k2nxf/hareproject/documents/working_test_no_chip.png

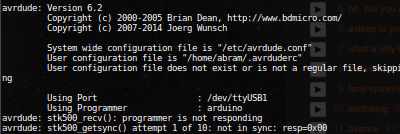
documents/working_test_no_chip.png
