k2nxf/hareproject/README.md

# hareproject
The hackable audio and real-time effects (H.A.R.E) project
