k2nxf/hareproject/documents/Homework 5 - Team 13.pdf

Homework #5
System Design: Functional Decomposition HARE Project

Team 13
Adam Oester
Abram Morphew
Zachary Clark-Williams
Ryan Fallis
High-Level | Block | Diagram:

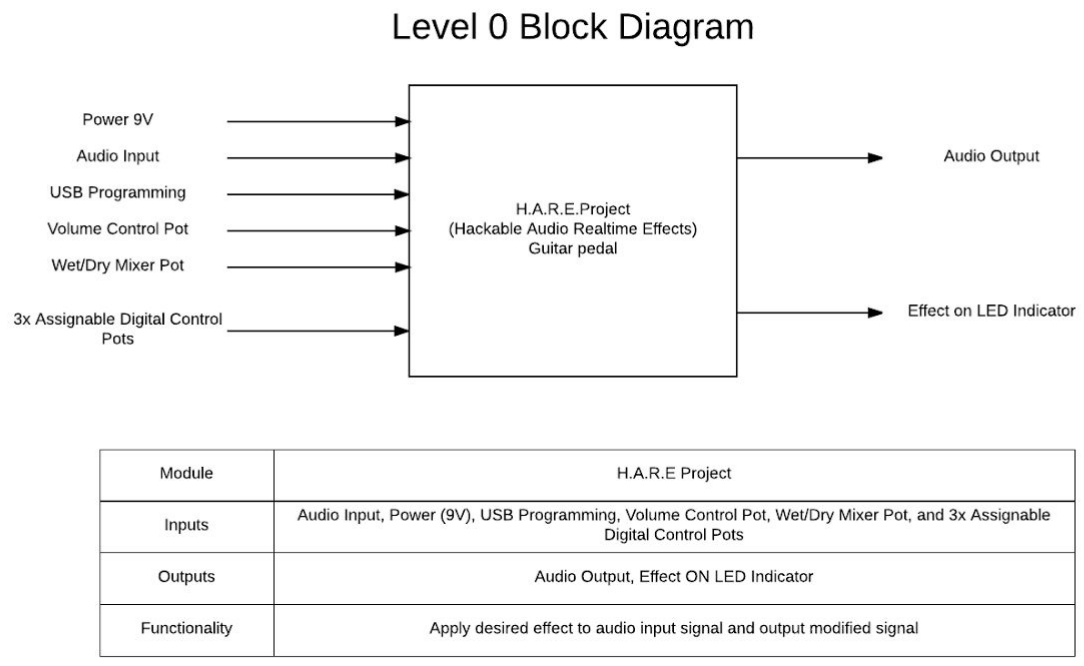
[picture p2: figure]

Next-Level | Block | Diagram:
| | Level 1 Block Diagram

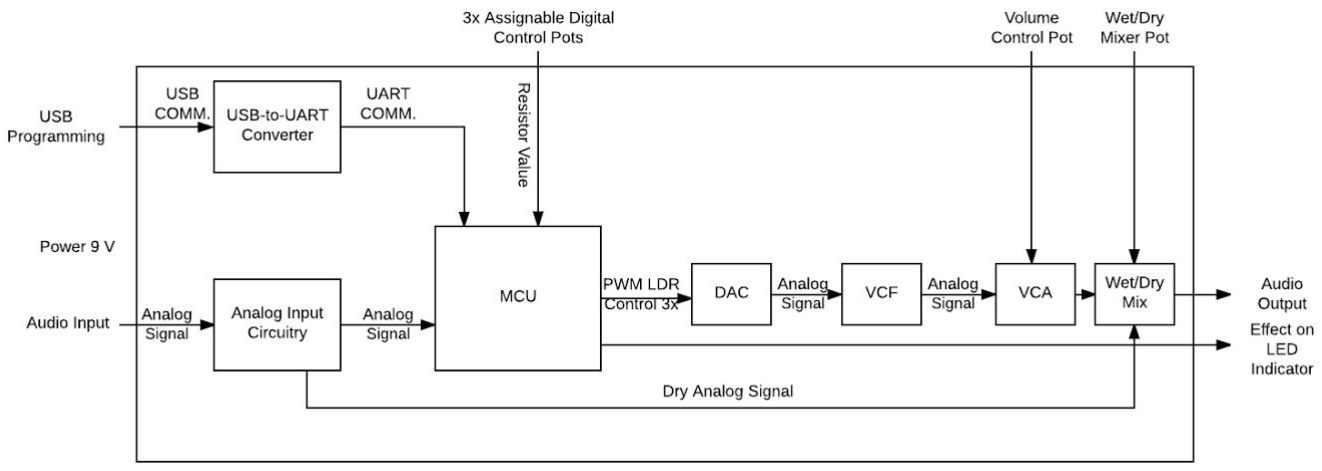
[picture p3: figure]

Top-Level | Module | Diagrams:
| | Top-Level Analog Input Circuitry

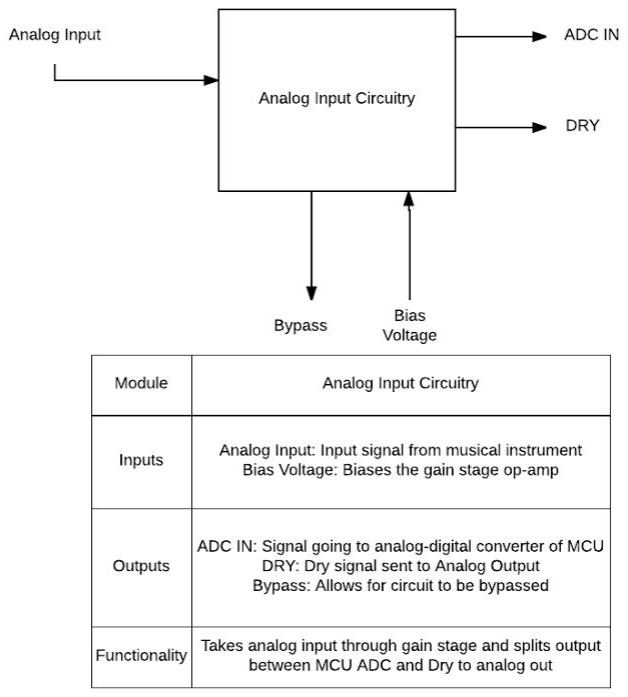
[picture p4: figure]

Top-Level USB-to-UART Diagram

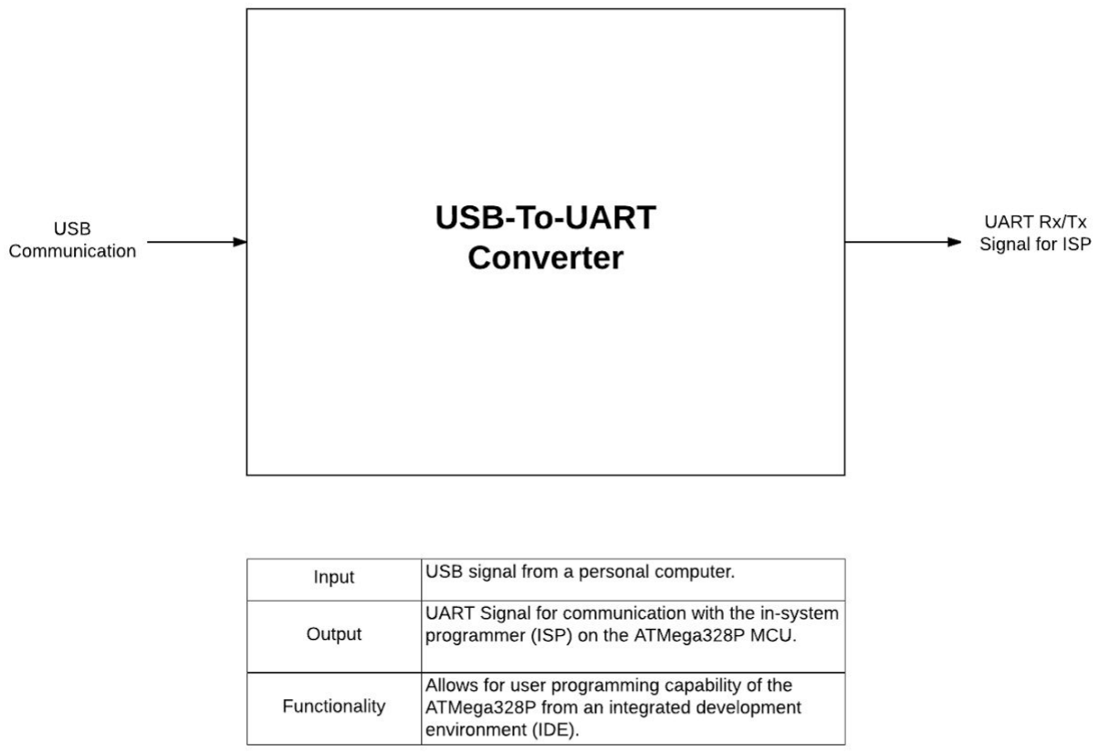
[picture p5: figure]

Top-Level MCU Diagram

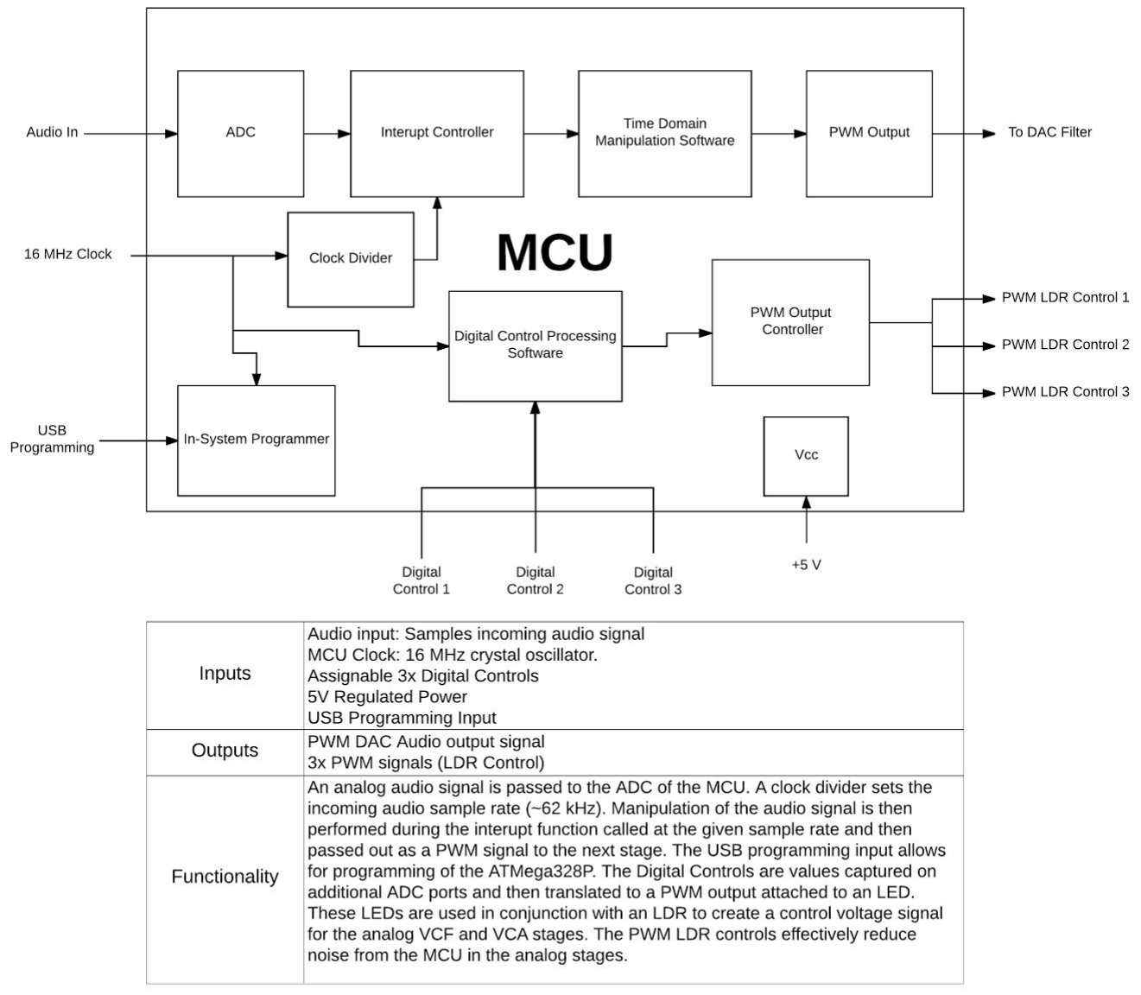
[picture p6: figure]

Top-Level PWM DAC Filter Diagram

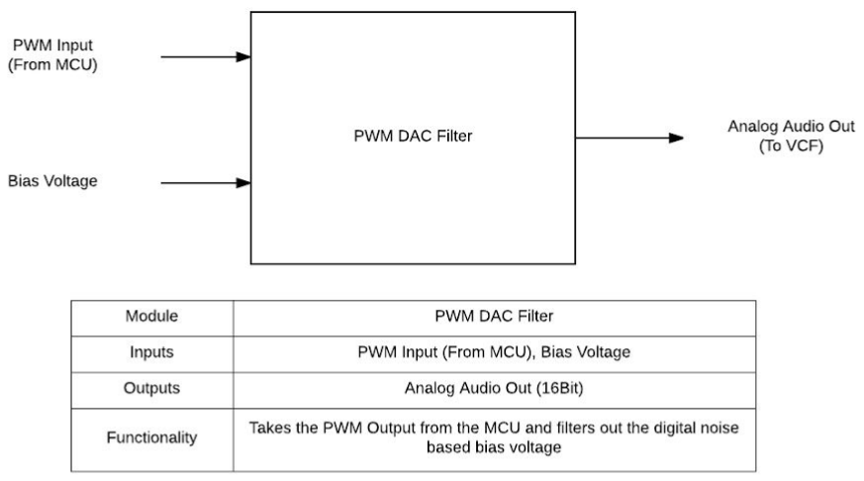
[picture p7: figure]

Top-Level Voltage Controlled Filter Diagram

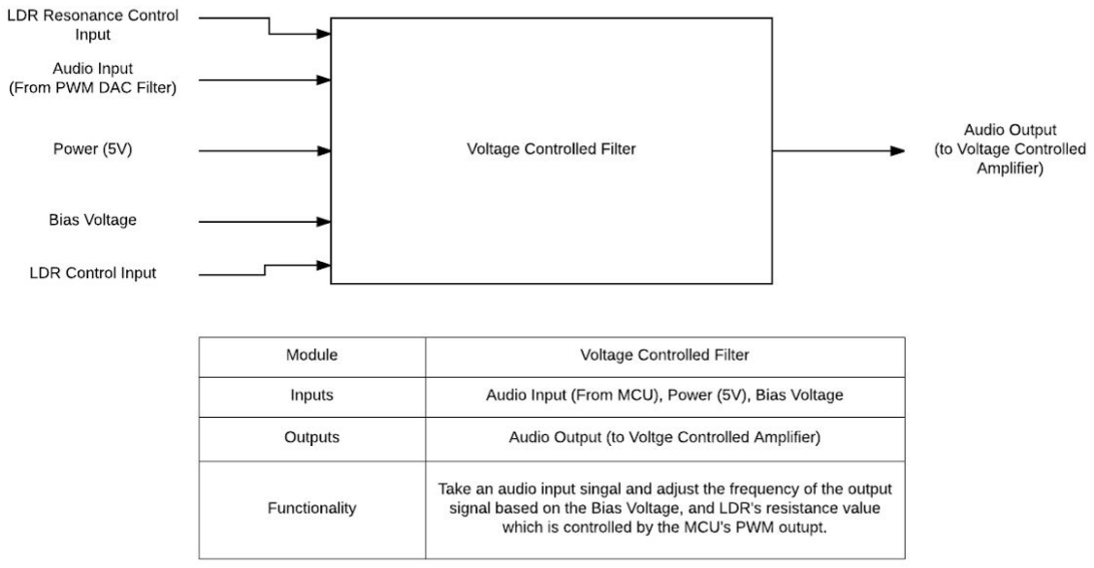
[picture p8: figure]

Top-Level Voltage-Controlled Amplifier Diagram

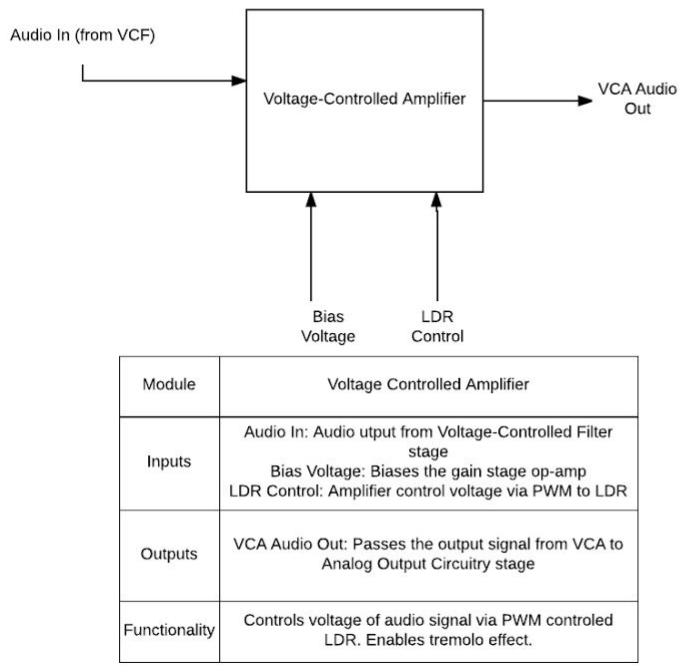
[picture p9: figure]

Top-Level Analog Output Circuitry Diagram

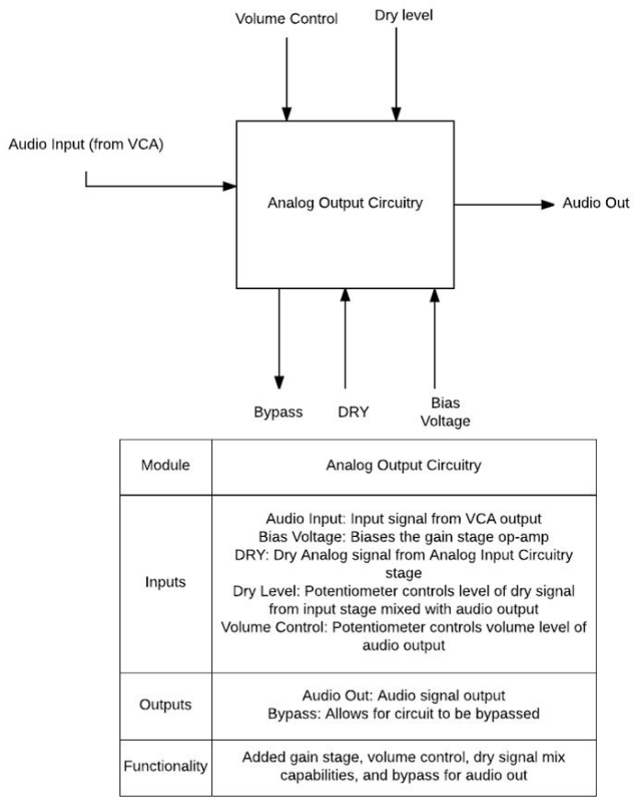
[picture p10: figure]
