k2nxf/hareproject/measurements/MCP4921_spectrum_1kHz.csv

Frequency (Hz) | Level (dB) | Frequency (kHz)
43.066406 | -49.579975 | 0.043066406
86.132812 | -50.937241 | 0.086132812
129.199219 | -65.967857 | 0.129199219
172.265625 | -69.474319 | 0.172265625
215.332031 | -72.966713 | 0.215332031
258.398438 | -74.523582 | 0.258398438
301.464844 | -70.056686 | 0.301464844
344.53125 | -74.955704 | 0.34453125
387.597656 | -77.206894 | 0.387597656
430.664062 | -75.691528 | 0.430664062
473.730469 | -78.37793 | 0.473730469
516.796875 | -73.04731 | 0.516796875
559.863281 | -72.713318 | 0.559863281
602.929688 | -78.147095 | 0.602929688
645.996094 | -76.161964 | 0.645996094
689.0625 | -77.673492 | 0.6890625
732.128906 | -81.486855 | 0.732128906
775.195312 | -80.535179 | 0.775195312
818.261719 | -76.385254 | 0.818261719
861.328125 | -68.273315 | 0.861328125
904.394531 | -48.475349 | 0.904394531
947.460938 | -24.801308 | 0.947460938
990.527344 | -16.720667 | 0.990527344
1033.59375 | -21.779499 | 1.03359375
1076.660156 | -42.519596 | 1.076660156
1119.726562 | -58.266113 | 1.119726562
1162.792969 | -62.753113 | 1.162792969
1205.859375 | -65.15596 | 1.205859375
1248.925781 | -66.968468 | 1.248925781
1291.992188 | -68.733795 | 1.291992188
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
