k2nxf/hareproject/documents/3pdt_breakout.png

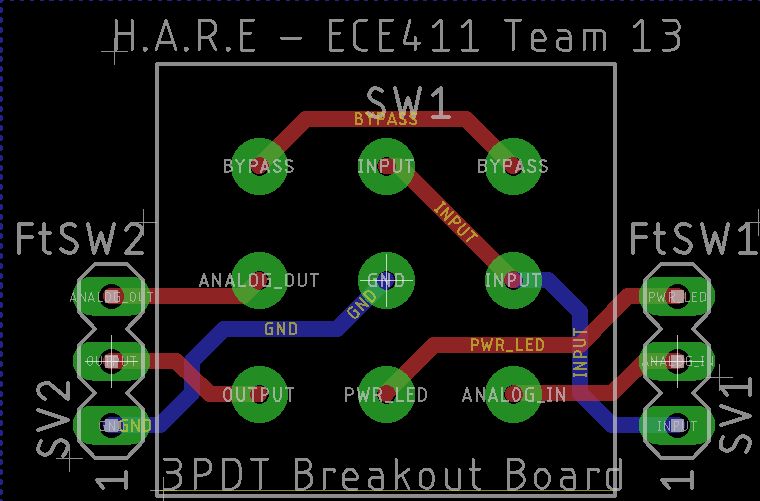
documents/3pdt_breakout.png
