k2nxf/hareproject/documents/arduino_due_fuse.png

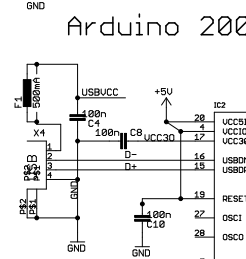
documents/arduino_due_fuse.png
