k2nxf/hareproject/documents/atmega328p.png

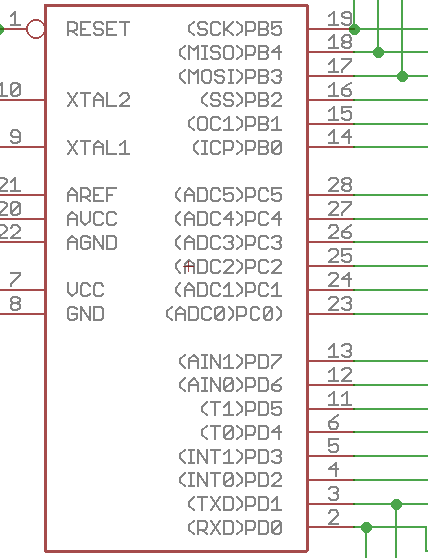
documents/atmega328p.png
