k2nxf/hareproject/documents/HARE_RAW.png

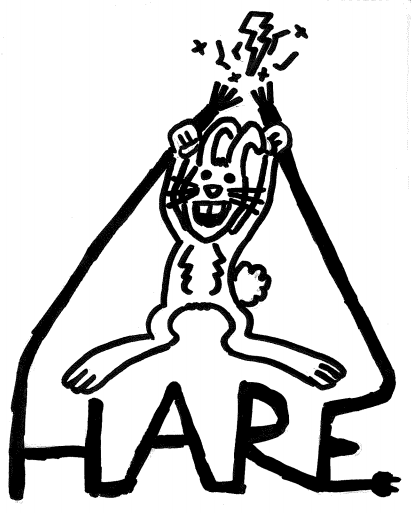
documents/HARE_RAW.png
