k2nxf/hareproject/documents/reset_conn.png

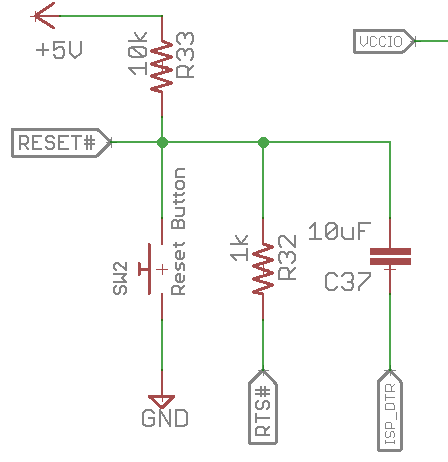
documents/reset_conn.png
