k2nxf/hareproject/schematics/SUPERBUN.bmp

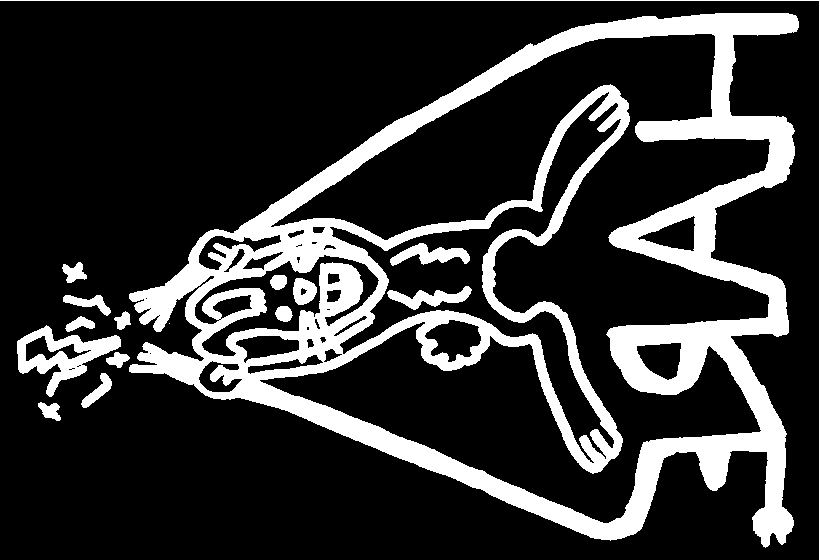
schematics/SUPERBUN.bmp
