k2nxf/hareproject/documents/Mouser_Cart_Oct23_1145PM.xls

SHOPPING CART
This is not an invoice
24-Oct-17 19:49:08
 | Mouser # | Mfr. # | Manufacturer | Customer # | Description | RoHS | Lifecycle | Order Qty. | Price (USD) | Ext.: (USD)
1 | 550-22302 | NMJ6HCD2 | Neutrik |  | Phone Connectors STEREO CHROME NOSE | RoHS Compliant |  | 14 | $1.32 | $18.48
2 | 667-ERJ-6RBD1003V | ERJ-6RBD1003V | Panasonic |  | Thick Film Resistors - SMD 0805 Resistor 0.5% 50ppm 100KOhm | RoHS Compliant | New Product | 100 | $0.045 | $4.50
3 | 754-RR1220P-103D | RR1220P-103-D | Susumu |  | Thin Film Resistors - SMD 1/10W 10Kohm 0.5% 25ppm | RoHS Compliant |  | 100 | $0.03 | $3.00
4 | 754-RR1220P-102D | RR1220P-102-D | Susumu |  | Thin Film Resistors - SMD 1/10W 1Kohm 0.5% 25ppm | RoHS Compliant |  | 100 | $0.03 | $3.00
5 | 754-RG2012P-473DT5 | RG2012P-473-D-T5 | Susumu |  | Thin Film Resistors - SMD 1/8W 47K Ohms 0.5% 0805 25ppm | RoHS Compliant |  | 30 | $0.16 | $4.80
6 | 81-GRM40X104K25L | GRM21BR71E104KA01L | Murata |  | Multilayer Ceramic Capacitors MLCC - SMD/SMT 0805 0.1uF 25volts X7R 10% | RoHS Compliant |  | 30 | $0.024 | $0.72
7 | 81-GCM21BR71E105KA6L | GCM21BR71E105KA56L | Murata |  | Multilayer Ceramic Capacitors MLCC - SMD/SMT 0805 1uF 25volts X7R 10% | RoHS Compliant |  | 100 | $0.062 | $6.20
8 | 963-TMK212BBJ106KGHT | TMK212BBJ106KGHT | Taiyo Yuden |  | Multilayer Ceramic Capacitors MLCC - SMD/SMT 10uF 25V X5R +/-10% 0805 AEC-Q200 | RoHS Compliant |  | 30 | $0.243 | $7.29
9 | 963-TMK212BJ224KGHT | TMK212BJ224KGHT | Taiyo Yuden |  | Multilayer Ceramic Capacitors MLCC - SMD/SMT 0.22uF 25V X5R +/-10% 0805 AEC-Q200 | RoHS Compliant |  | 30 | $0.055 | $1.65
10 | 538-67068-7041 | 67068-7041 | Molex |  | USB Connectors 4CKT TYPE B RECPT | RoHS Compliant |  | 5 | $1.33 | $6.65
11 | 895-FT232RL | FT232RL-REEL | FTDI |  | USB Interface IC USB to Serial UART Enhanced IC SSOP-28 | RoHS Compliant |  | 5 | $4.50 | $22.50
12 | 490-PJ-102B | PJ-102B | CUI Inc. |  | DC Power Connectors Power Jacks | RoHS Compliant |  | 5 | $0.64 | $3.20
13 | 863-MC7805BDTRKG | MC7805BDTRKG | ON Semiconductor |  | Linear Voltage Regulators 5V 1A Positive | RoHS Compliant |  | 10 | $0.52 | $5.20
14 | 72-TS53YL-10K | TS53YL103MR10 | Vishay |  | Trimmer Resistors - SMD 10Kohms 20% SQ POT | RoHS Compliant By Exemption |  | 10 | $1.25 | $12.50
15 | 710-742792093 | 742792093 | Wurth Electronics |  | Ferrite Beads WE-CBF 0805 SMD Bead 100MHz 2200Ohm 200mA | RoHS Compliant |  | 10 | $0.20 | $2.00
16 | 603-RC0805JR-072K2L | RC0805JR-072K2L | Yageo |  | Thick Film Resistors - SMD 2.2K OHM 5% | RoHS Compliant |  | 20 | $0.013 | $0.26
By submitting your order you agree to these terms and conditions. (https://www.mouser.com/saleterms) |  |  |  |  |  |  |  |  | Merchandise Total: | $101.95
Prices are reflected at the date and time shown. |  |  |  |  |  |  |  |  | Shipping Charge: | Estimate
