k2nxf/hareproject/documents/INPUT_TEST.xlsx

Test Writer: Adam Oester
Test Case Name: |  | Input signal pass through |  |  | Test ID #: | INPUT_TEST
Description: |  | The user sends in a known input signal (100 Hz, 1 kHz and 10 kHz) to the input op-amp set to a known gain (Unity, 3, 6, and 9). The user then records both the input and the output signal for analysis. |  |  | Type: | black box
Tester Information
Name of Tester: |  | Adam Oester |  | Date: |  | 2017-12-05
Hardware Version: |  | HAREproject Rev 1.0 |  | Time: |  | 23:37:00
Setup: |  | HARE guitar pedal main board with at least the input circuitry populated. Function generator and oscilloscope channel 1 hooked-up to the op-amp input and oscilloscope channel 2 hooked-up to the input circuitry output.
Special instructions: |  | Hook input and output up to oscilloscope, use function generator to create known analog input signal, ensure to record gain setting and capture oscilloscope screen capture
Step | Action | Expected Result | Pass | Fail | N/A | Comments
1 | 100 Hz input signal at unity gain | Clean output signal @ 100 Hz +/- 50 Hz with no distortion or harmonics. Ensure signal has unity gain. | PASS |  |  | This test is being completed on a fully populated board. No major harmonic signals present.
2 | 1 kHz input signal at unity gain | Clean output signal @ 1 kHz +/- 50 Hz with no distortion or harmonics. Ensure signal has unity gain. | PASS
3 | 10 kHz input signal at unity gain | Clean output signal @ 10 kHz +/- 50 Hz with no distortion or harmonics. Ensure signal has unity gain. | PASS
4 | 100 Hz input signal at gain of 3 | Clean output signal @ 100 Hz +/- 50 Hz with no distortion or harmonics. Ensure signal has gain of 3. | PASS
5 | 1 kHz input signal at gain of 3 | Clean output signal @ 1 kHz +/- 50 Hz with no distortion or harmonics. Ensure signal has gain of 3. | PASS
6 | 10 kHz input signal at gain of 3 | Clean output signal @ 10 kHz +/- 50 Hz with no distortion or harmonics. Ensure signal has gain of 3. | PASS
7 | 100 Hz input signal at gain of 6 | Clean output signal @ 100 Hz +/- 50 Hz with no distortion or harmonics. Ensure signal has gain of 6. | PASS |  | Marginal Pass. See Comments | Unit has gain of slightly less than 6. Gain is ~5.5
8 | 1 kHz input signal at gain of 6 | Clean output signal @ 1 kHz +/- 50 Hz with no distortion or harmonics. Ensure signal has gain of 6. | PASS |  | Marginal Pass. See Comments | Unit has gain of slightly less than 6. Gain is ~5.5
9 | 10 kHz input signal at gain of | Clean output signal @ 10 kHz +/- 50 Hz with no distortion or harmonics. Ensure signal has gain of 6. | PASS |  | Marginal Pass. See Comments | Unit has gain of slightly less than 6. Gain is ~5.5
Overall Test Result: |  |  | PASS |  |  | Units gain tops out at approximately 5.5.
