k2nxf/hareproject/measurements/ADC-to-DAC_pass-through_at_1kHz_20171116.png

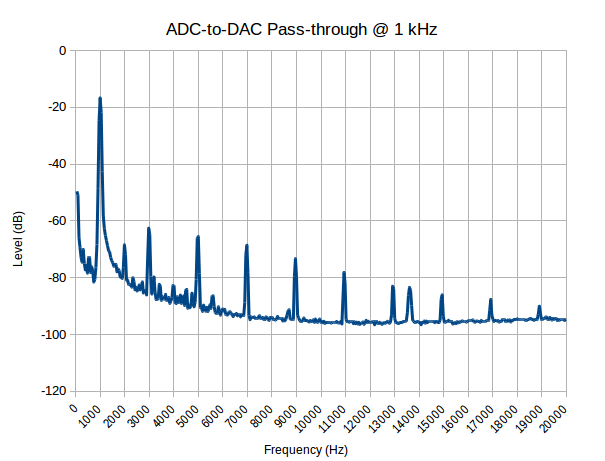
measurements/ADC-to-DAC_pass-through_at_1kHz_20171116.png
