k2nxf/hareproject/measurements/HARE_Analog_input_20171105a.png

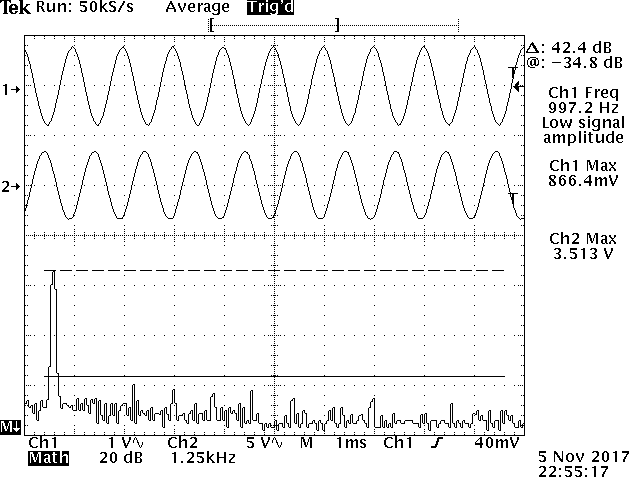
measurements/HARE_Analog_input_20171105a.png
