k2nxf/hareproject/measurements/HARE_Analog_out_20171105a.png

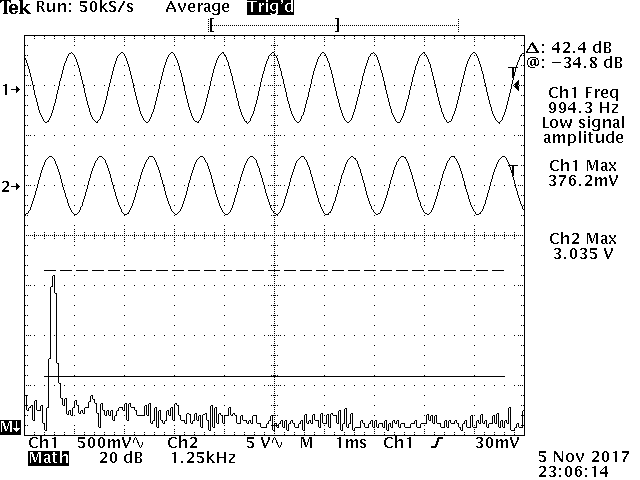
measurements/HARE_Analog_out_20171105a.png
