k2nxf/hareproject/measurements/HARE_PWMDAC_20171105c.png

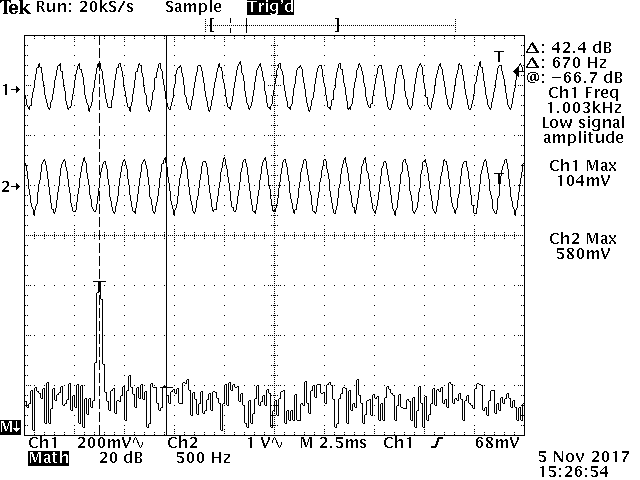
measurements/HARE_PWMDAC_20171105c.png
