k2nxf/hareproject/measurements/HARE_SPI_SCK_MOSI_20171115.png

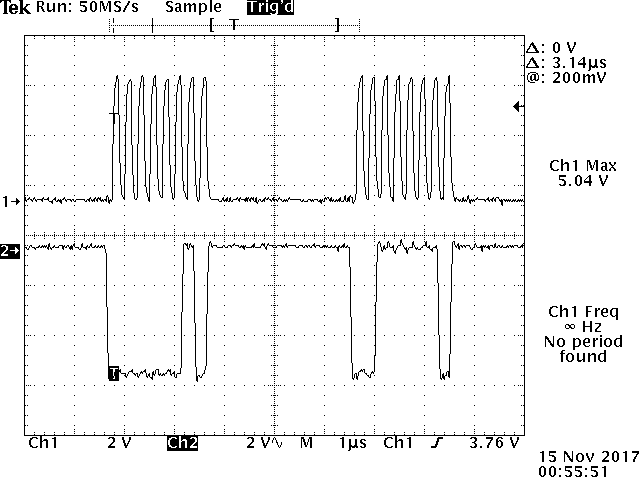
measurements/HARE_SPI_SCK_MOSI_20171115.png
