k2nxf/hareproject/documents/Project_schedule_full.pdf

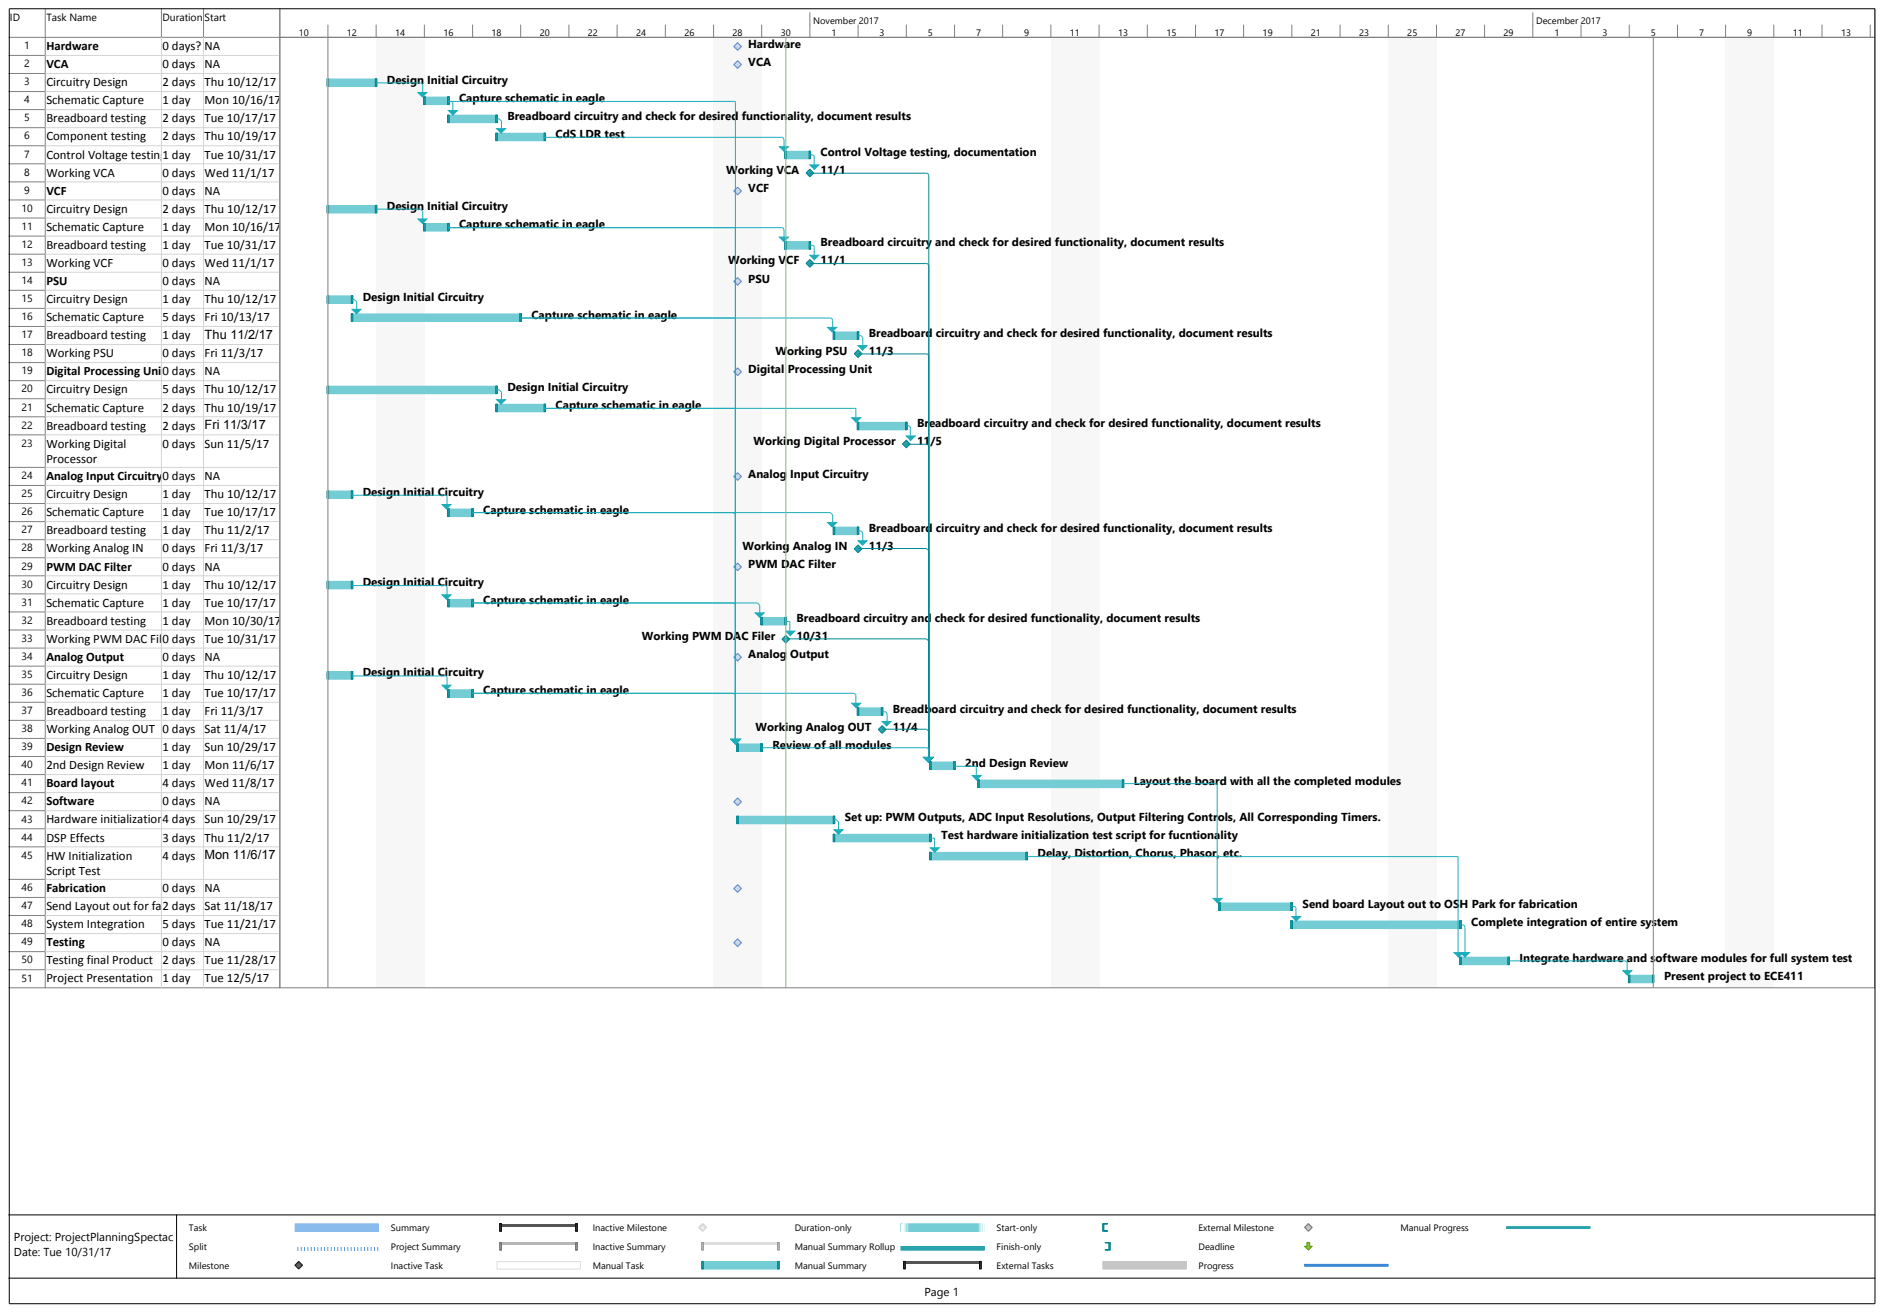
[picture p25: page 1]
Task Name; Duration Start; Hardware; 0 days? NA; VCA; Working VCA; VCF; Working VCF; PSU; Working PSU; Working Digital Processor; Working Analog IN; Working PWM DAC Filer; Analog Output; Working Analog OUT; 2nd Design Review; November 2017; December 2017; Task; Split; Milestone; Summary; Project Summary; Inactive Task; Inactive Milestone; Inactive Summary; Manual Task; Duration-only; Manual Summary; Start-only; Finish-only; External Tasks; External Milestone; Deadline; Progress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

2 | VCA | 0 days | NA
3 | Circuitry Design | 2 days | Thu 10/12/17
4 | Schematic Capture | 1 day | Mon 10/16/17
5 | Breadboard testing | 2 days | Tue 10/17/17
6 | Component testing | 2 days | Thu 10/19/17
7 | Control Voltage testing1 day | | Tue 10/31/17
8 | Working VCA | 0 days | Wed 11/1/17
9 | VCF | 0 days | NA
10 | Circuitry Design | 2 days | Thu 10/12/17
11 | Schematic Capture | 1 day | Mon 10/16/17
12 | Breadboard testing | 1 day | Tue 10/31/17
13 | Working VCF | 0 days | Wed 11/1/17
14 | PSU | 0 days | NA
15 | Circuitry Design | 1 day | Thu 10/12/17
16 | Schematic Capture | 5 days | Fri 10/13/17
17 | Breadboard testing | 1 day | Thu 11/2/17
18 | Working PSU | 0 days | Fri 11/3/17
19 | Digital Processing Unit0 days | | NA
20 | Circuitry Design | 5 days | Thu 10/12/17
21 | Schematic Capture | 2 days | Thu 10/19/17
22 | Breadboard testing | 2 days | Fri 11/3/17
23 | Working Digital Processor | 0 days | Sun 11/5/17

Design Initial Circuitry

Capture schematic in eagle

Breadboard circuitry and check for desired functionality, document results

CdS LDR test

Control Voltage testing, documentation

Digital Processing Unit

24 | Analog Input Circuitry0 days | | NA
25 | Circuitry Design | 1 day | Thu 10/12/17
26 | Schematic Capture | 1 day | Tue 10/17/17
27 | Breadboard testing | 1 day | Thu 11/2/17
28 | Working Analog IN | 0 days | Fri 11/3/17
29 | PWM DAC Filter | 0 days | NA
30 | Circuitry Design | 1 day | Thu 10/12/17
31 | Schematic Capture | 1 day | Tue 10/17/17
32 | Breadboard testing | 1 day | Mon 10/30/17
33 | Working PWM DAC Filer0 days | | Tue 10/31/17
34 | Analog Output | 0 days | NA
35 | Circuitry Design | 1 day | Thu 10/12/17
36 | Schematic Capture | 1 day | Tue 10/17/17
37 | Breadboard testing | 1 day | Fri 11/3/17
38 | Working Analog OUT | 0 days | Sat 11/4/17
39 | Design Review | 1 day | Sun 10/29/17
40 | 2nd Design Review | 1 day | Mon 11/6/17
41 | Board layout | 4 days | Wed 11/8/17
42 | Software | 0 days | NA
43 | Hardware initialization4 days | | Sun 10/29/17
44 | DSP Effects | 3 days | Thu 11/2/17
45 | HW Initialization Script Test | 4 days | Mon 11/6/17

Analog Input Circuitry

PWM DAC Filter

Review of all modules

Layout the board with all the completed modules

Set up: PWM Outputs, ADC Input Resolutions, Output Filtering Controls, All Corresponding Timers.

Test hardware initialization test script for fucntionality

Delay, Distortion, Chorus, Phasor, etc.

46 | Fabrication | 0 days | NA
47 | Send Layout out for fabrication 2 days | | Sat 11/18/17
48 | System Integration | 5 days | Tue 11/21/17
49 | Testing | 0 days | NA
50 | Testing final Product | 2 days | Tue 11/28/17
51 | Project Presentation | 1 day | Tue 12/5/17

Send board Layout out to OSH Park for fabrication

Complete integration of entire system

Integrate hardware and software modules for full system test

Present project to ECE411

Manual Summary Rollup
