k2nxf/hareproject/documents/Drawing+NMJ6HCD2.pdf

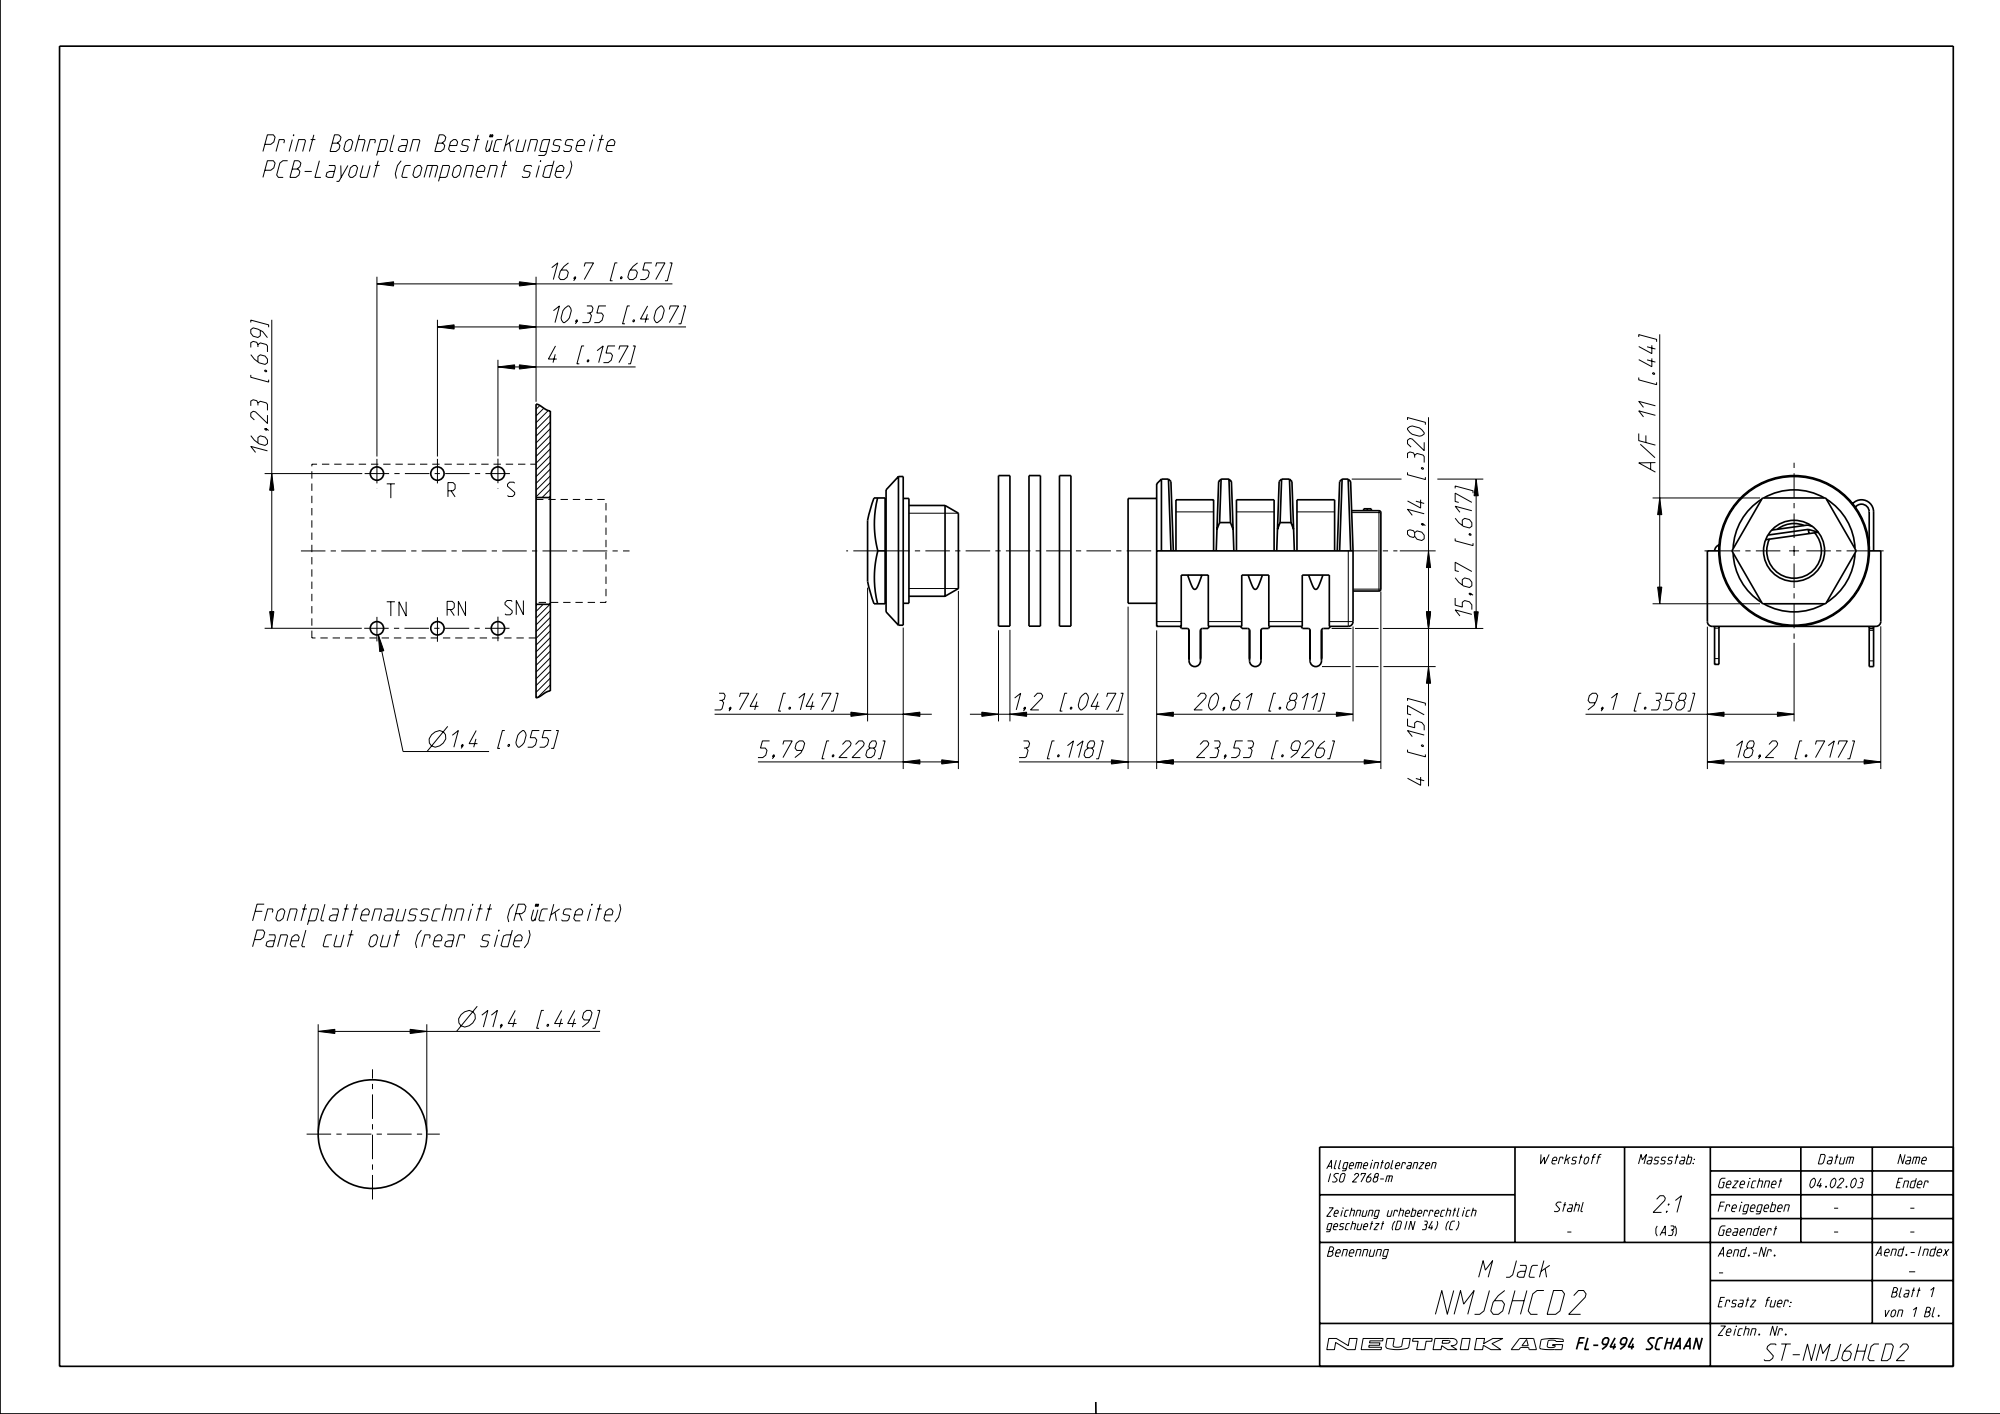
[picture p26: page 1]
