k2nxf/hareproject/simulations/simple_VCF_simulation.asc

C1: cap; 100µ
C2: cap; 10µ
C3: cap; 0.47µ
C4: cap; 0.22µ
C5: cap; 0.22µ
C6: cap; 1µ
C7: cap; 100p
D1: diode; 1N4148
R1: res; 10k
R2: res; 10k
R3: res; 47k
R4: res; 100k
R5: res; 400
R6: res; 100k
R7: res; 1k
R8: res; 1k
R9: res; 50k
R10: res; 50k
U1: BA4580R
V1: voltage; 9.6V
V2: voltage; SINE(0 0.1 1k); AC 1
V3: voltage; {Vc}; Rser=4
Named nets: 0, Vcc, Vb, Vout, CV
.ac oct 1000 1 100MEG
.step param Vc 0 5 1
