k2nxf/hareproject/schematics/HARE - Master Schematic v2.0.brd

## EAGLE design schematics/HARE - Master Schematic v2.0.brd (2017-12-10)

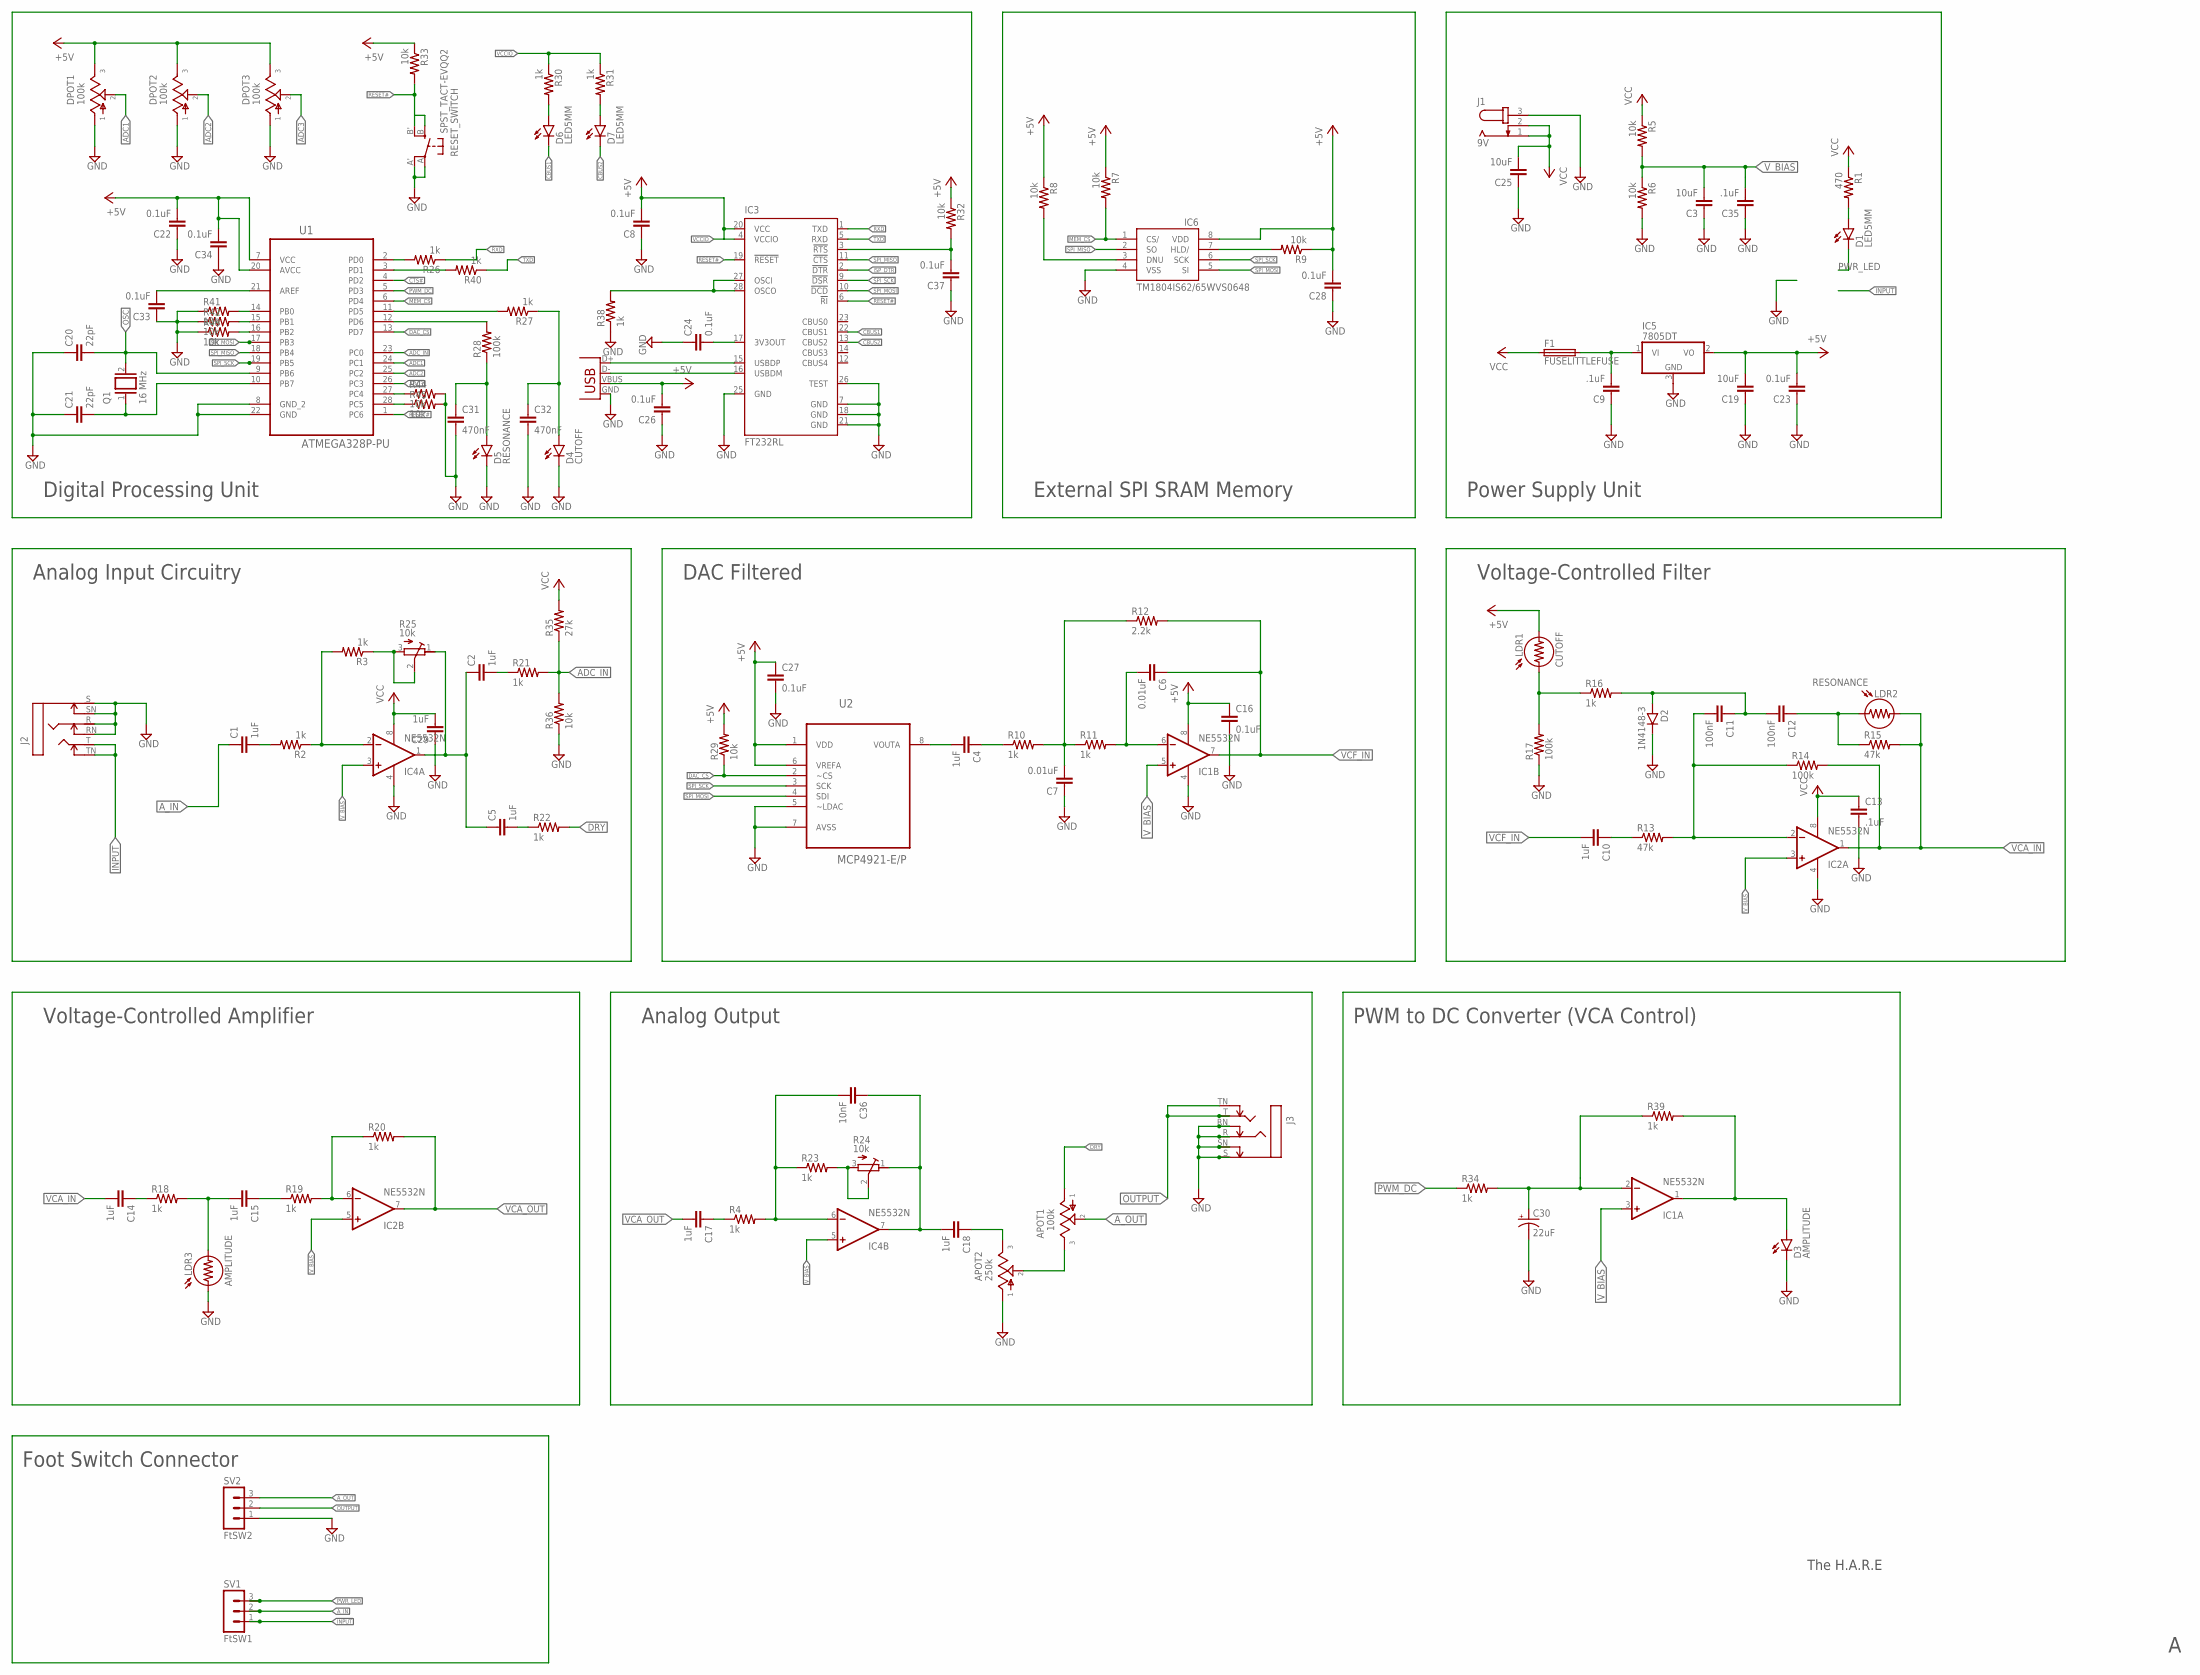
[picture p27: schematic HARE - Master Schematic v2.0.sch]

Parts:
APOT1: 100k; 16MM-SQUARE
APOT2: 250k; 16MM-SQUARE
C1, C2, C4, C5, C10, C14, C15, C17, C18, C29: 1uF; C0805K
C3, C19, C25: 10uF; C0805K
C6, C7: 0.01uF; C0805K
C8, C16, C22, C23, C24, C26, C27, C28, C33, C34, C37: 0.1uF; C0805K
C9, C13, C35: .1uF; C0805K
C11, C12: 100nF; C0805K
C20, C21: 22pF; C0805K
C30: 22uF; 050_020_1
C31, C32: 470nF; 072X035
C36: 10nF; C0805K
D1, D6, D7: LED5MM
D2: 1N4148-3; DO35-3
D3: AMPLITUDE; LED5MM
D4: CUTOFF; LED5MM
D5: RESONANCE; LED5MM
DPOT1, DPOT2, DPOT3: 100k; 16MM-SQUARE
F1: FUSELITTLEFUSE; LITTLEFUSE
IC1, IC2, IC4: NE5532N; DIL08
IC3: FT232RL; SSOP28
IC5: 7805DT; TO252
IC6: TM1804IS62/65WVS0648; SO08
J1: 9V; SPC4078
J2, J3: STEREOSW; NMJ6HCD2
LDR1: CUTOFF; LDR338-54C
LDR2: RESONANCE; LDR338-54C
LDR3: AMPLITUDE; LDR338-54C
Q1: 16 MHz; QS
R1: 470; M0805
R2, R3, R4, R10, R11, R16, R18, R19, R20, R21, R22, R23, R26, R27, R30, R31, R34, R38, R39, R40: 1k; R0805
R5, R6, R7, R8, R9: 10k; M0805
R12: 2.2k; R0805
R13, R15: 47k; R0805
R14, R17, R28: 100k; R0805
R24, R25: 10k; RTRIM3314G
R29, R32, R33, R36, R41, R42, R43, R44, R45: 10k; R0805
R35: 27k; R0805
RESET_SWITCH: SPST_TACT-EVQQ2; EVQ-Q2
SV1: FtSW1; MA03-1
SV2: FtSW2; MA03-1
U1: ATMEGA328P-PU; DIP254P762X457-28
U2: MCP4921-E/P; DIP254P762X432-8
X2: USB-B-H

Connections:
+5V: C16.1, C19.2, C22.2, C23.2, C26.2, C27.1, C28.2, C34.2, DPOT1.3, DPOT2.3, DPOT3.3, IC1.8 (V+), IC5.2 (VO), IC6.8 (VDD), LDR1.2, R7.1, R8.1, R9.1, R29.2, R32.1, R33.1, U1.7 (VCC), U1.20 (AVCC), U2.1 (VDD), U2.6 (VREFA), X2.VBUS
+5V1: C33.2, U1.21 (AREF)
ADC1: DPOT1.2, U1.24 (PC1)
ADC2: DPOT2.2, U1.25 (PC2)
ADC3: DPOT3.2, U1.26 (PC3)
ADC_IN: R21.2, R35.1, R36.2, U1.23 (PC0)
A_IN: C1.1, SV1.2
A_OUT: APOT1.2, SV2.3
CBUS1: D6.K (C), IC3.22 (CBUS1)
CBUS2: D7.K (C), IC3.13 (CBUS2)
CTS#: U1.4 (PD2)
DAC_CS: R29.1, U1.13 (PD7), U2.2 (~CS)
DRY: APOT1.1, R22.2
GND: APOT2.1, C3.1, C7.1, C8.1, C9.1, C13.2, C16.2, C19.1, C20.1, C21.1, C22.1, C23.1, C24.1, C25.1, C26.1, C27.2, C28.1, C29.1, C30.-, C31.2, C32.2, C33.1, C34.1, C35.1, C37.1, D2.C, D3.K (C), D4.K (C), D5.K (C), DPOT1.1, DPOT2.1, DPOT3.1, IC1.4 (V-), IC2.4 (V-), IC3.7 (GND), IC3.18 (GND), IC3.21 (GND), IC3.25 (GND), IC3.26 (TEST), IC4.4 (V-), IC5.3 (GND), IC6.4 (VSS), J1.3, J2.R, J2.RN, J2.S, J2.SN, J3.R, J3.RN, J3.S, J3.SN, LDR3.1, R6.2, R17.1, R36.1, R38.1, R41.1, R42.1, R43.1, R44.2, R45.2, RESET_SWITCH.A, RESET_SWITCH.A' (P1), SV2.1, U1.8 (GND_2), U1.22 (GND), U2.5 (~LDAC), U2.7 (AVSS), X2.GND
INPUT: J2.T, J2.TN, SV1.1
ISP_DTR: IC3.2 (!DTR)
MEM_CS: IC6.1 (CS/), R7.2, U1.6 (PD4)
unnamed: D1.A, R1.2
unnamed: IC6.7 (HLD/), R9.2
unnamed: C1.2, R2.2
unnamed: IC4.2 (-IN), R2.1, R3.2
unnamed: C4.2, U2.8 (VOUTA)
unnamed: C4.1, R10.1
unnamed: C5.2, R22.1
unnamed: C30.+, IC1.2 (-IN), R34.2, R39.1
unnamed: C7.2, R10.2, R11.1, R12.1
unnamed: C6.2, IC1.6 (-IN), R11.2
unnamed: IC6.3 (DNU), R8.2
unnamed: D3.A, IC1.1 (OUT), R39.2
unnamed: C10.1, R13.1
unnamed: C11.2, IC2.2 (-IN), R13.2, R14.1
unnamed: C37.2, IC3.3 (!RTS), R32.2
unnamed: C12.1, LDR2.1, R15.1
unnamed: C11.1, C12.2, D2.A, R16.2
unnamed: IC3.27 (OSCI), IC3.28 (OSCO), R38.2
unnamed: LDR1.1, R16.1, R17.2
unnamed: C14.1, R18.1
unnamed: C15.2, LDR3.2, R18.2
unnamed: C15.1, R19.1
unnamed: IC2.6 (-IN), R19.2, R20.1
unnamed: C9.2, F1.2, IC5.1 (VI)
unnamed: R26.2, U1.2 (PD0)
unnamed: C2.2, R21.1
unnamed: C2.1, C5.1, IC4.1 (OUT), R25.1 (E)
unnamed: R40.2, U1.3 (PD1)
unnamed: R41.2, U1.14 (PB0)
unnamed: C17.1, R4.1
unnamed: C36.2, IC4.6 (-IN), R4.2, R23.1
unnamed: R23.2, R24.2 (S), R24.3 (A)
unnamed: C18.2, C36.1, IC4.7 (OUT), R24.1 (E)
unnamed: R42.2, U1.15 (PB1)
unnamed: APOT2.3, C18.1
unnamed: APOT1.3, APOT2.2
unnamed: R43.2, U1.16 (PB2)
unnamed: R3.1, R25.2 (S), R25.3 (A)
unnamed: R44.1, U1.27 (PC4)
unnamed: C21.2, Q1.1, U1.10 (PB7)
unnamed: IC3.15 (USBDP), X2.D+
unnamed: IC3.16 (USBDM), X2.D-
unnamed: C24.2, IC3.17 (3V3OUT)
unnamed: R45.1, U1.28 (PC5)
unnamed: R28.2, U1.12 (PD6)
unnamed: C31.1, D5.A, R28.1
unnamed: R27.2, U1.11 (PD5)
unnamed: C32.1, D4.A, R27.1
unnamed: D6.A, R30.2
unnamed: D7.A, R31.2
OSC: C20.2, Q1.2, U1.9 (PB6)
OUTPUT: J3.T, J3.TN, SV2.2
PWM_DC: R34.1, U1.5 (PD3)
PWR_LED: D1.K (C), SV1.3
RESET#: IC3.6 (!RI), IC3.19 (!RESET), R33.2, RESET_SWITCH.B (S), RESET_SWITCH.B' (S1), U1.1 (PC6)
RXD: IC3.1 (TXD), R26.1
SPI_MISO: IC3.11 (!CTS), IC6.2 (SO), U1.18 (PB4)
SPI_MOSI: IC3.10 (!DCD), IC6.5 (SI), U1.17 (PB3), U2.4 (SDI)
SPI_SCK: IC3.9 (!DSR), IC6.6 (SCK), U1.19 (PB5), U2.3 (SCK)
TXD: IC3.5 (RXD), R40.1
VCA_IN: C14.2, IC2.1 (OUT), LDR2.2, R14.2, R15.2
VCA_OUT: C17.2, IC2.7 (OUT), R20.2
VCC: C13.1, C25.2, C29.2, F1.1, IC2.8 (V+), IC4.8 (V+), J1.1, J1.2, R1.1, R5.1, R35.2
VCCIO: C8.2, IC3.4 (VCCIO), IC3.20 (VCC), R30.1, R31.1
VCF_IN: C6.1, C10.2, IC1.7 (OUT), R12.2
V_BIAS: C3.2, C35.2, IC1.3 (+IN), IC1.5 (+IN), IC2.3 (+IN), IC2.5 (+IN), IC4.3 (+IN), IC4.5 (+IN), R5.2, R6.1

Notes on the sheet:
Power Supply Unit
Digital Processing Unit
Analog Output
Voltage-Controlled Filter
Voltage-Controlled Amplifier
Analog Input Circuitry
DAC Filtered
External SPI SRAM Memory
The H.A.R.E
Foot Switch Connector
PWM to DC Converter (VCA Control)

Board: 2 copper layers, 113 parts (0 on the bottom side), 81 nets, no tracks yet.
