k2nxf/hareproject/schematics/HARE - 3PDT Breakout Schematic v1.0.brd

## EAGLE design schematics/HARE - 3PDT Breakout Schematic v1.0.brd (2017-11-16)

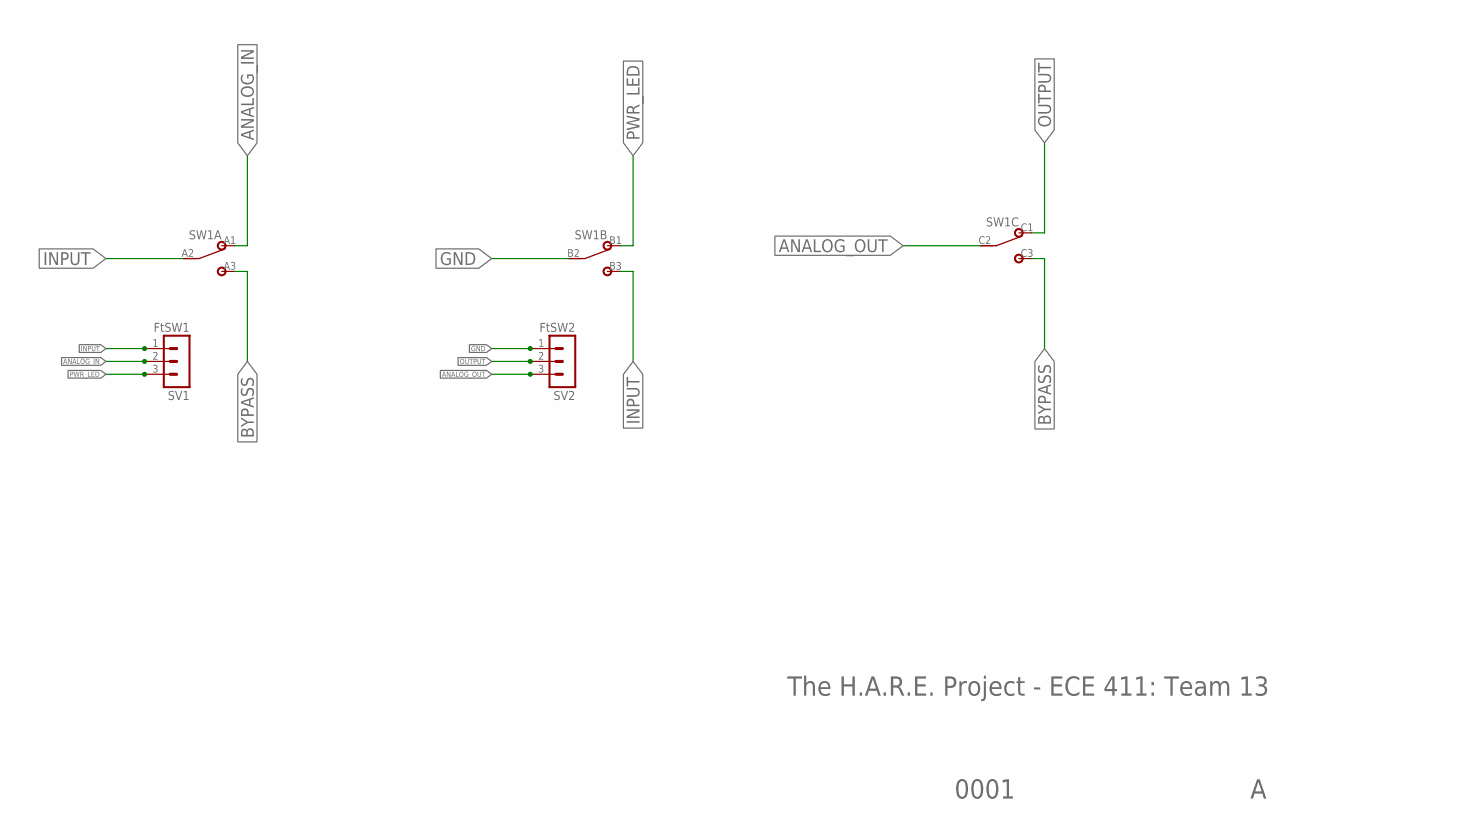
[picture p28: schematic HARE - 3PDT Breakout Schematic v1.0.sch]

Parts:
SV1: FtSW1; MA03-1
SV2: FtSW2; MA03-1
SW1: 3PDTBLUE; CHINABLUE

Connections:
ANALOG_IN: SV1.2, SW1.A1 (1)
ANALOG_OUT: SV2.3, SW1.C2 (2)
BYPASS: SW1.A3 (3), SW1.C3 (3)
GND: SV2.1, SW1.B2 (2)
INPUT: SV1.1, SW1.A2 (2), SW1.B3 (3)
OUTPUT: SV2.2, SW1.C1 (1)
PWR_LED: SV1.3, SW1.B1 (1)

Notes on the sheet:
The H.A.R.E. Project - ECE 411: Team 13
0001

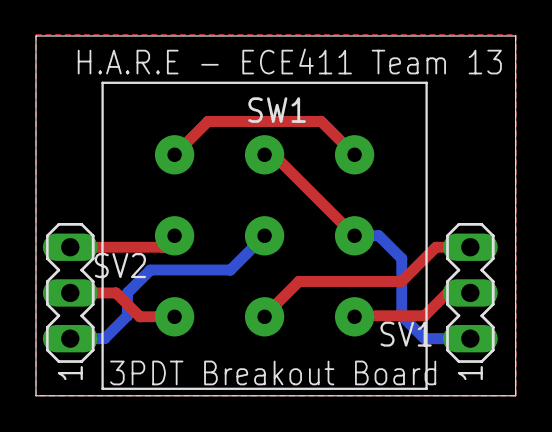
[picture p29: board HARE - 3PDT Breakout Schematic v1.0.brd from above]

Board: 2 copper layers, 26.7 x 20.0 mm, 3 parts (0 on the bottom side), 7 nets.
