k2nxf/hareproject/schematics/FT232_BreakOutBoard.brd

## EAGLE design schematics/FT232_BreakOutBoard.brd (2017-11-02)

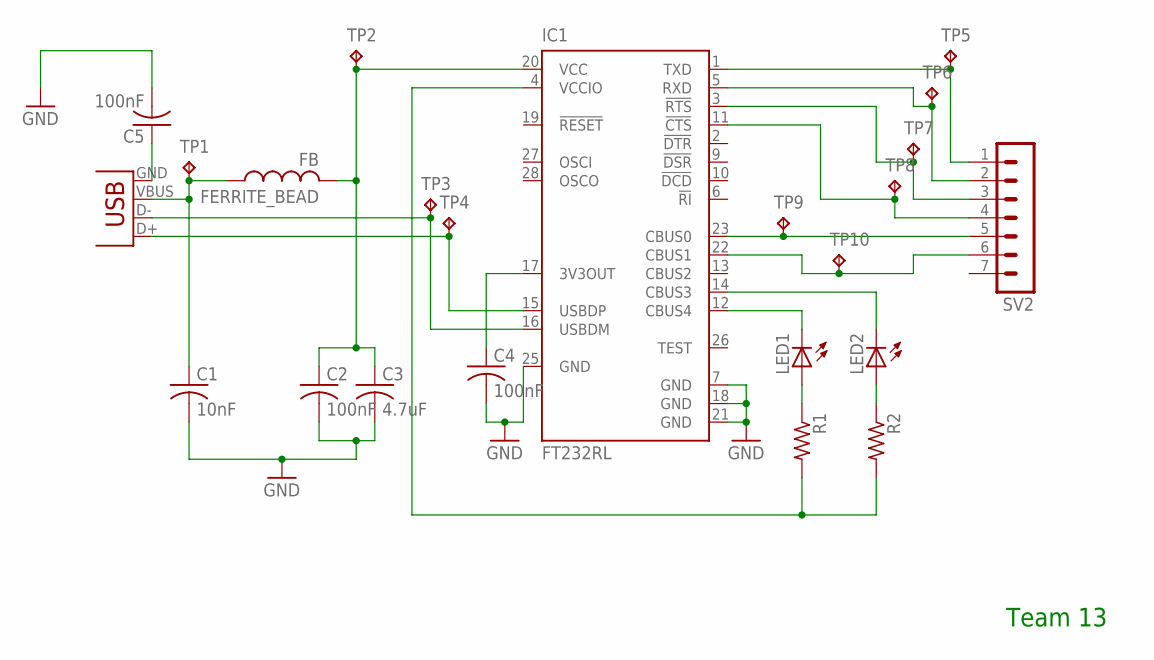
[picture p30: schematic FT232_BreakOutBoard.sch]

Parts:
C1: 10nF; C0805
C2, C4, C5: 100nF; C0805
C3: 4.7uF; C0805
FERRITE_BEAD: FB
IC1: FT232RL; SSOP28
LED1, LED2: LEDCHIPLED_0805; CHIPLED_0805
R1, R2: R-US_R0805; R0805
SV2: MA07-1
TP1, TP2, TP3, TP4, TP5, TP6, TP7, TP8, TP9, TP10: TPB1,27; B1,27
X1: USB-B-H

Connections:
DELEETE: IC1.4 (VCCIO), R1.2, R2.2
GND: C1.2, C2.2, C3.2, C4.2, C5.2, IC1.7 (GND), IC1.18 (GND), IC1.21 (GND), IC1.25 (GND)
unnamed: C5.1, X1.GND
unnamed: C4.1, IC1.17 (3V3OUT)
unnamed: IC1.15 (USBDP), TP4.TP, X1.D+
unnamed: IC1.16 (USBDM), TP3.TP, X1.D-
unnamed: IC1.1 (TXD), SV2.1, TP5.TP
unnamed: C1.1, FERRITE_BEAD.P$1 (1), TP1.TP, X1.VBUS
unnamed: IC1.5 (RXD), SV2.2, TP6.TP
unnamed: IC1.3 (!RTS), SV2.3, TP7.TP
unnamed: IC1.11 (!CTS), SV2.4, TP8.TP
unnamed: IC1.23 (CBUS0), SV2.5, TP9.TP
unnamed: LED2.A, R2.1
unnamed: LED1.A, R1.1
unnamed: IC1.22 (CBUS1), SV2.6, TP10.TP
unnamed: IC1.12 (CBUS4), LED1.C
unnamed: IC1.14 (CBUS3), LED2.C
unnamed: C2.1, C3.1, FERRITE_BEAD.P$2 (2), IC1.20 (VCC), TP2.TP

Notes on the sheet:
Team 13

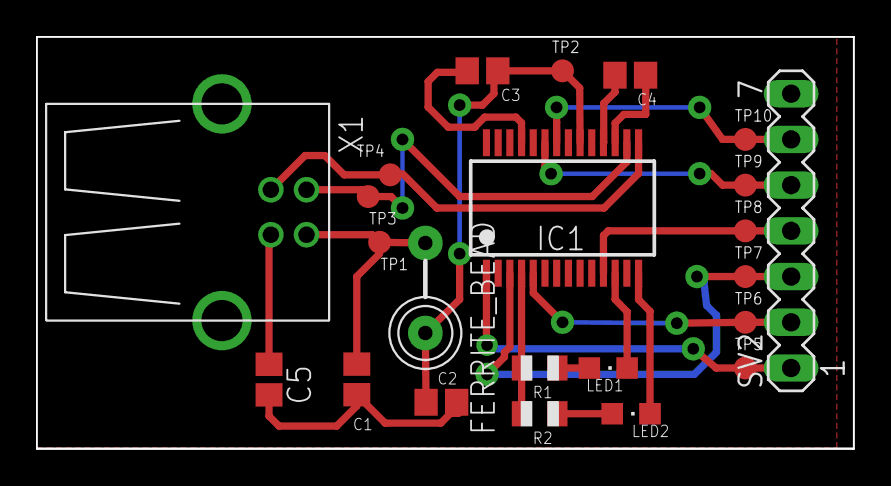
[picture p31: board FT232_BreakOutBoard.brd from above]

Board: 2 copper layers, 45.4 x 22.9 mm, 23 parts (0 on the bottom side), 18 nets.
