k2nxf/hareproject/(commit log)

2017-10-19 Adding initial Eagle schematic and board layout
    [HARE_schematic_10172017.brd, HARE_schematic_10172017.sch]
2017-10-19 updating schematic
    [HARE_schematic_10172017.sch]
2017-10-22 Upload FT232R Breakout Board
    [FT232_BreakOutBoard.sch]
2017-10-22 updated schematic with analog modules
2017-10-22 Updated schematic and board layout
    [HARE_schematic_10172017.brd, HARE_schematic_10172017.sch]
2017-10-24 arduino code to test PWM control of analog modules
2017-10-25 Completed schematic update
    [Mouser_Cart_Oct23_1145PM.xls]
2017-10-25 Updating first schematic build
    [HARE_schematic_10172017.brd, HARE_schematic_10172017.sch]
2017-10-25 Update Schematic
    [HARE_schematic_10172017.sch]
2017-10-25 Update board layout
    Update board layout to match schematic updates.
    [HARE_schematic_10172017.brd]
2017-10-25 Connected FT232 to reset switch.
    [HARE_schematic_10172017.brd, HARE_schematic_10172017.sch]
2017-10-27 Added DAC_OUT node to schematic
    [HARE_schematic_10172017.brd, HARE_schematic_10172017.sch]
2017-10-27 updated breakout board layout and schematic
    [FT232_BreakOutBoard.brd, FT232_BreakOutBoard.sch]
2017-11-02 Updated clean code with new PWM mode
2017-11-02 Updated FT232 break-out board with corrected USB connector and larger vias
    [FT232_BreakOutBoard.brd, FT232_BreakOutBoard.sch]
2017-11-02 FT232 break-out board update
2017-11-02 Fixed ERC errors
    [HARE_schematic_10172017.brd, HARE_schematic_10172017.sch]
2017-11-02 Resolved errors and most warnings in ERC
    [HARE_schematic_10172017.brd, HARE_schematic_10172017.sch]
2017-11-03 update breakout board with all loins connected
    [FT232_BreakOutBoard_rev2.sch]
2017-11-06 Added PWMDAC and DAC filter measurements.
2017-11-06 Added PWMDAC filter measurements
2017-11-06 Added External Memory Device
    Added External SPI EEPROM Memory Device - CAT25512 (AT25512)
    [HARE_Main_Sch_Rev1.sch]
2017-11-06 Switch memory chip to SRAM
    [HARE_Main_Sch_Rev1.sch]
2017-11-06 fix WP pin on SRAM chip to DNU
    [HARE_Main_Sch_Rev1.sch]
2017-11-06 Added measurements for PWMDAC and analog in/out.
2017-11-09 Created master schematic and board layout
    [HARE - Master Schematic v1.0.brd, HARE - Master Schematic v1.0.sch]
2017-11-09 Updated master schematic
    [HARE_schematic_10172017.brd, HARE_schematic_10172017.sch]
2017-11-10 Started the eagle layout and fixed a few errors in the schematic
    [HARE - Master Schematic v1.0.brd, HARE - Master Schematic v1.0.sch]
2017-11-10 added OSH Park DRC rules to schematics folder
2017-11-10 The beginning of a board. Need to route power and move some resistors and capacitors
    [HARE - Master Schematic v1.0.brd]
2017-11-12 First pass at board layout and updated schematic
    [HARE - Master Schematic v1.0.brd, HARE - Master Schematic v1.0.sch]
2017-11-13 Updated clean function with ADC and PWM init routines
2017-11-13 Updated clean program with ADC and PWM capabilities
2017-11-13 Added team number to master schematic
    [HARE - Master Schematic v1.0.sch]
2017-11-13 Zack DiD it!
    [HARE - Master Schematic v1.0.sch]
2017-11-13 Added IC bypass caps
    [HARE - Master Schematic v1.0.sch]
2017-11-14 ZACK DEFINITELY DID ITgit add schematics/HARE\ -\ Master\ Schematic\ v1.0.sch schematics/HARE\ -\ Master\ Schematic\ v1.0.brd !
    [HARE - Master Schematic v1.0.brd, HARE - Master Schematic v1.0.sch]
2017-11-14 Adding initial routing for footswitch cutout
    [HARE - Master Schematic v1.0.brd]
2017-11-14 Updated VCF and PWM LEDs filters
    [HARE - Master Schematic v1.0.brd, HARE - Master Schematic v1.0.sch, HARE_Main_Sch_Rev1.sch]
2017-11-14 Updated VCF component values and added PWM LED filters
    [HARE - Master Schematic v1.0.brd]
2017-11-14 Updated the board file to include cutout for foot switch and some greenburg recommendations
    [HARE - Master Schematic v1.0.brd, HARE - Master Schematic v1.0.sch]
2017-11-14 fixed the board and schematic files
    [HARE - Master Schematic v1.0.brd, HARE - Master Schematic v1.0.sch]
2017-11-14 no DRC errors in board file
    [HARE - Master Schematic v1.0.brd]
2017-11-14 fixed a couple ERC issues
    [HARE - Master Schematic v1.0.sch]
2017-11-14 PWM-to-DC converter added for VCA control, VCF changes fixed, and fuse added
    [HARE - Master Schematic v1.0.brd, HARE - Master Schematic v1.0.sch]
2017-11-14 Added filtering cap to analog output circuitry
    [HARE - Master Schematic v1.0.brd, HARE - Master Schematic v1.0.sch]
2017-11-14 Added high frequency filter cap to analog output circuitry
    [HARE - Master Schematic v1.0.brd, HARE - Master Schematic v1.0.sch]
2017-11-15 Adding 3PDT breakout board schematic and layout
    [HARE - 3PDT Breakout Schematic v1.0.brd, HARE - 3PDT Breakout Schematic v1.0.sch]
2017-11-15 Completed routing high frequency filter caps
    [HARE - Master Schematic v1.0.brd, HARE - Master Schematic v1.0.sch]
2017-11-15 adapting 3PDT breakout board to mate with HARE main board
    [HARE - 3PDT Breakout Schematic v1.0.brd, HARE - 3PDT Breakout Schematic v1.0.sch]
2017-11-15 Correctly placed the 3PDT switch connectors to mate with the main board
    [HARE - 3PDT Breakout Schematic v1.0.brd, HARE - 3PDT Breakout Schematic v1.0.sch]
2017-11-15 new chip and bootloader
    [HARE - Master Schematic v1.0.brd, HARE - Master Schematic v1.0.sch]
2017-11-15 Added SPI oscilloscope measurements for SCK and MOSI pins (MCP4921 communication)
2017-11-15 Updated clean effect with SPI routines
2017-11-16 Added SuperBun Image to brd
    [HARE - Master Schematic v1.0.brd]
2017-11-16 Add files via upload
    Bottom layer board image
2017-11-16 How to add image to board layout
    Brief instructions for adding a bitmap image to silkscreen layer
2017-11-16 Finished Board layout without art
    [HARE - Master Schematic v1.0.brd, HARE - Master Schematic v1.0.sch]
2017-11-16 finished board layout with HAREBUN artwork on bottom of board
    [HARE - Master Schematic v1.0.brd]
2017-11-16 Shrank the size of the daughter board for the footswitch
    [HARE - 3PDT Breakout Schematic v1.0.brd]
2017-11-16 REV 1 for HARE ready for tapeout
    [HARE - Master Schematic v1.0.brd, HARE - Master Schematic v1.0.sch]
2017-11-16 REV 1 of HARE with correct artwork ready for tapeout
    [HARE - Master Schematic v1.0.brd]
2017-12-06 Adding some additional documents and measuremnts
    [MCP4921_spectrum_1kHz.csv, MCP4921_spectrum_1kHz.ods]
2017-12-07 Latest clean code update. Photos of prototypes also uploaded.
2017-12-07 uploading test plan and completed INPUT TEST
    [INPUT_TEST.xlsx]
2017-12-10 Updated with Resolved Comm. Issues
    TXD/RXD switched, CTS and RTS removed from reset along with R37 and C37, set up correct ISCP for SPI boot loading from FT232, Tied VCCIO to 5V and changed the name of the board
    [HARE - Master Schematic v2.0.sch]
2017-12-10 updated to match sch
    [HARE - Master Schematic v2.0.brd]
